Kunalverma1502/Vesc-Shield/README.md

# ⚡️Vesc-Shield 

The Vesc-Shield is a remarkable open-source shield designed for effortless integration with the [Flipsky Vesc 6.7 Pro](https://flipsky.net/products/flipsky-mini-fsesc6-7-pro-70a-base-on-vesc6-6-with-aluminum-anodized-heat-sink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). By doing so, it enables cost-effective utilization in a wide range of robotic applications while affording precise driver control through the seamless integration of Dspace.

# Features 
1. **Enhanced Motor Encoder Output:** Amplifies motor encoder output signals for both Vesc and Dspace, ensuring optimal performance and precision.<br/>
1. **Effortless Position Reset:** Facilitates easy and precise index position resetting, whether through digital or manual methods.<br/>
1. **Motor Driver Control:** Provides the capability to enable or disable the motor driver with simplicity and efficiency.<br/>
1. **Streamlined Connectivity:** Utilizes a single ribbon cable connection to Dspace, consolidating all essential signals for a tidy and efficient setup.<br/>
1. **Informative LEDs:** Equipped with LEDs that display vital information, including power status, enable/disable status, and index reset, ensuring at-a-glance monitoring and feedback.<br/>

# Schematics
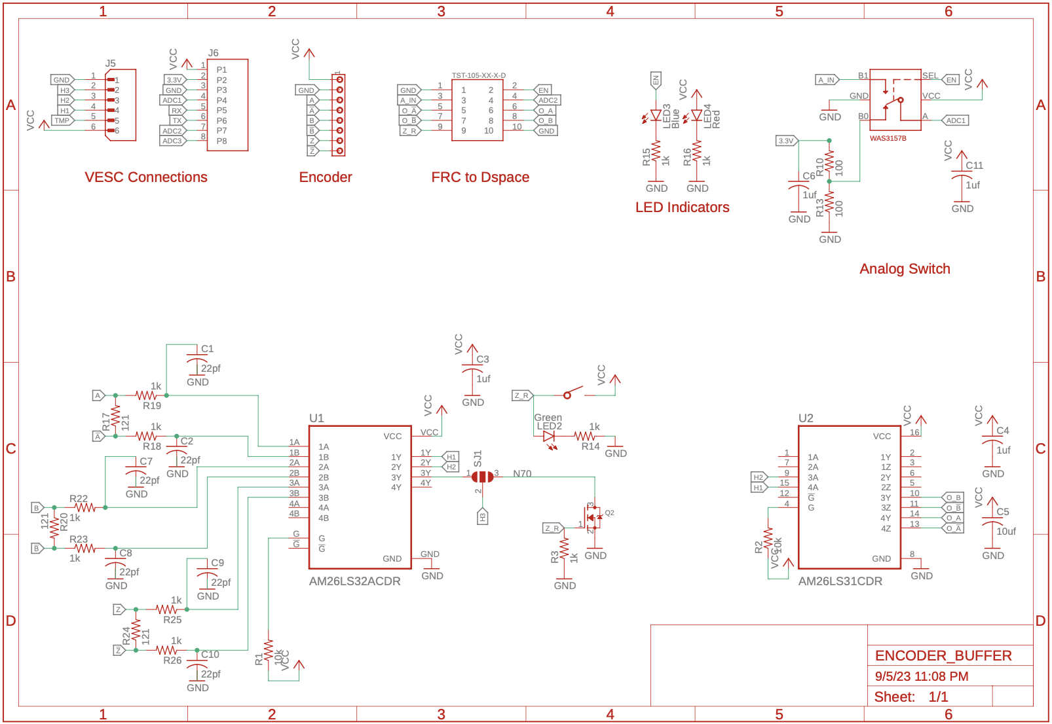
[picture p1: Images/Schematic 2.png]

<br/>
<br/>

# Board 
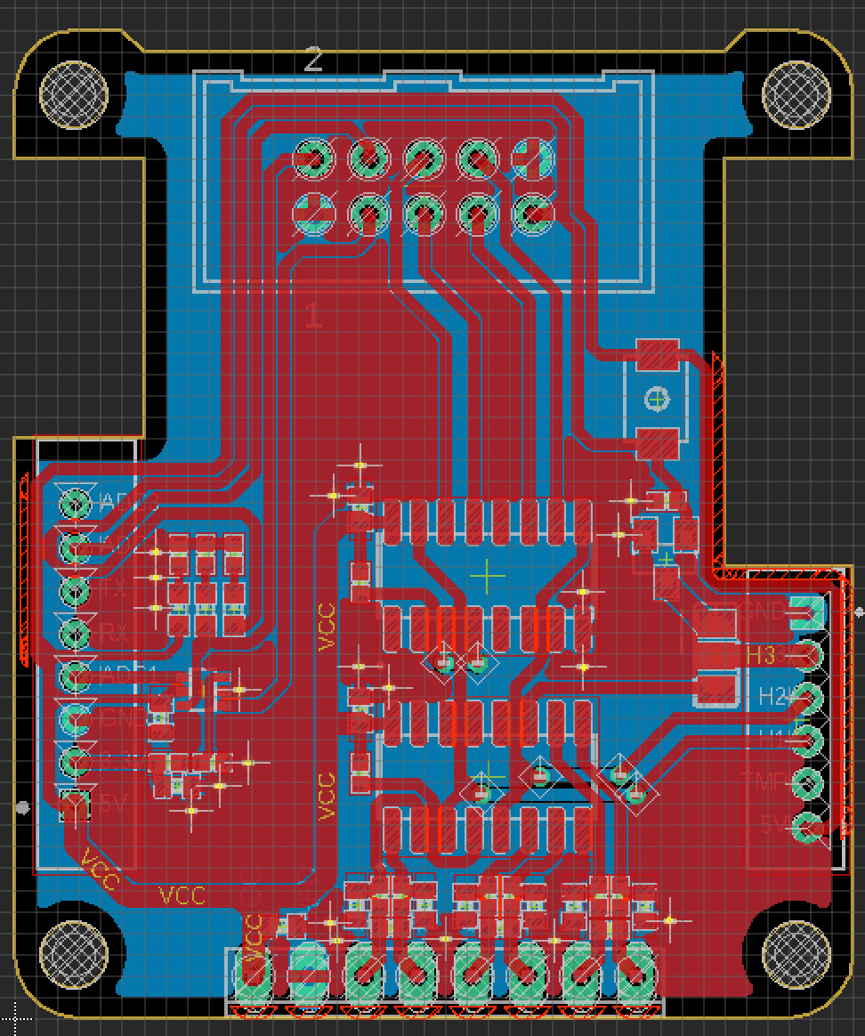
[picture p2: Images/Board.png]

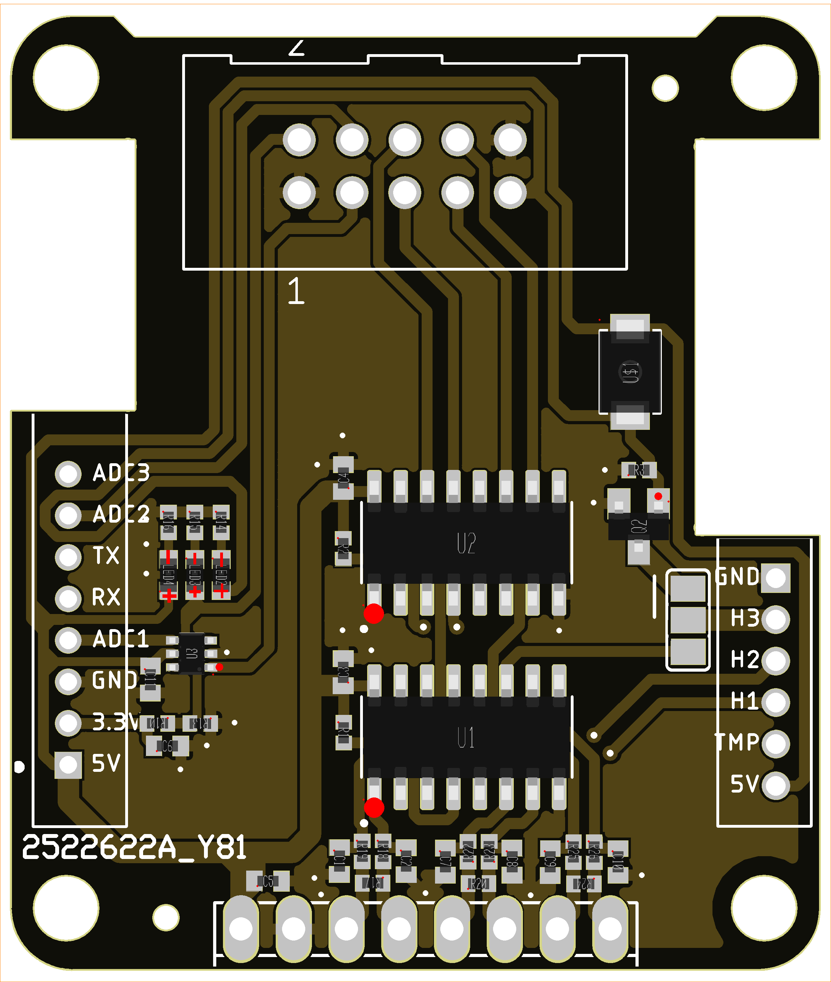
[picture p3: Images/Parts Placement.png]
