Kunalverma1502/Vesc-Shield/Images/Schematics.png

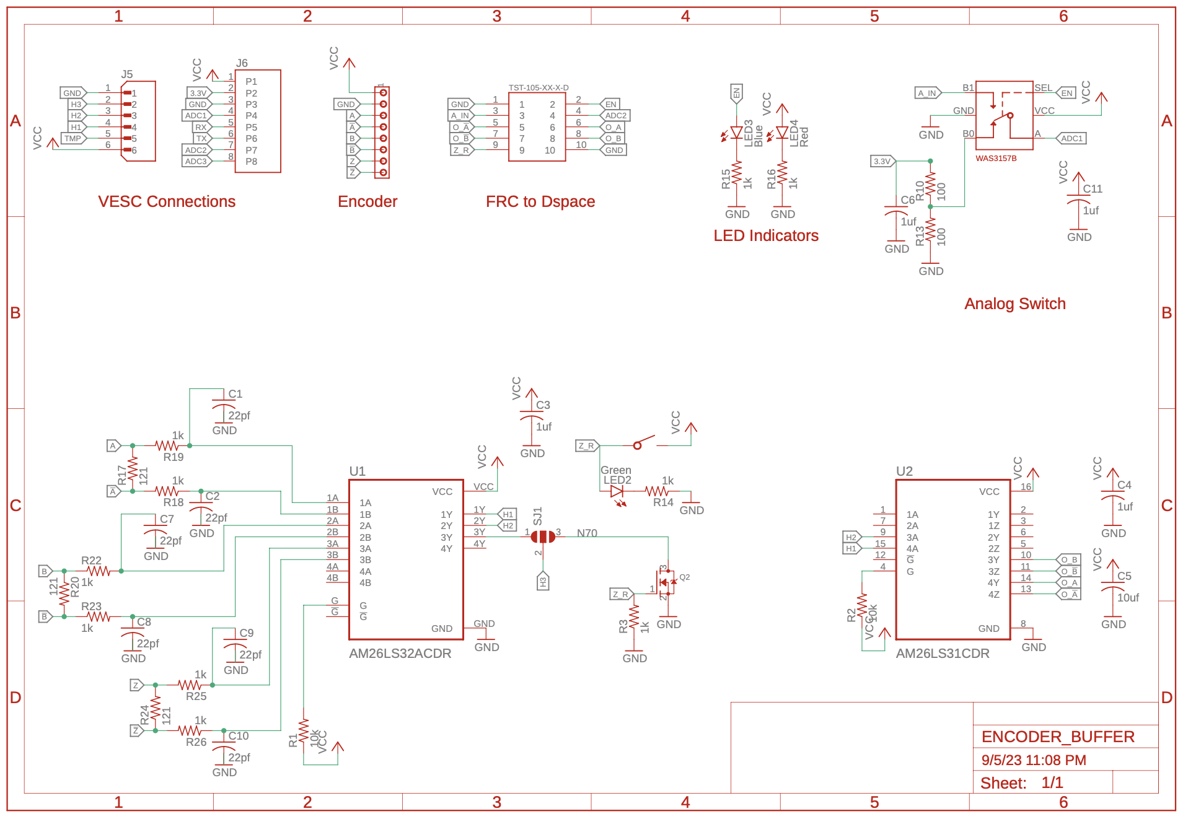
Images/Schematics.png
