Kunalverma1502/Vesc-Shield/PCB Files/ORDER/BOM_ENCODER_BUFFER.xlsx

Comment | Designator | Footprint | JLCPCB Part #（optional）
SI2300 | Q2 | SOT-23 | C2985622
100 | R10, R13 | R0402 | C325391
10k | R1, R2 | R0402 | C375970
10uf | C5 | C0402 | C703695
121 | R17, R20, R24 | R0402 | C25080
1k | R3, R14, R15, R16, R18, R19, R22, R23, R25, R26 | R0402 | C306197
1uf | C3, C4, C6, C11 | C0402 | C415694
22pf | C1, C2, C7, C8, C9, C10 | C0402 | C694268
AM26LS31CDR | U2 | SOIC-16 | C6179
AM26LS32ACDR | U1 | SOIC-16 | C6180
19-213UYOC/S530-A3/TR8 | LED3 | 603 | C264452
19-21/GHC-YR1S2M/3T | LED2 | 603 | C605453
TJ-S1608SW6TDSLC2R2G-A5 | LED4 | 603 | C601671
TS-1088-AR02016 | U$1 | SMD | C720477
WAS3157B-6/TR | U3 | SOT-363 | C213161
