Kunalverma1502/Vesc-Shield/PCB Files/ENCODER_BUFFER.pdf

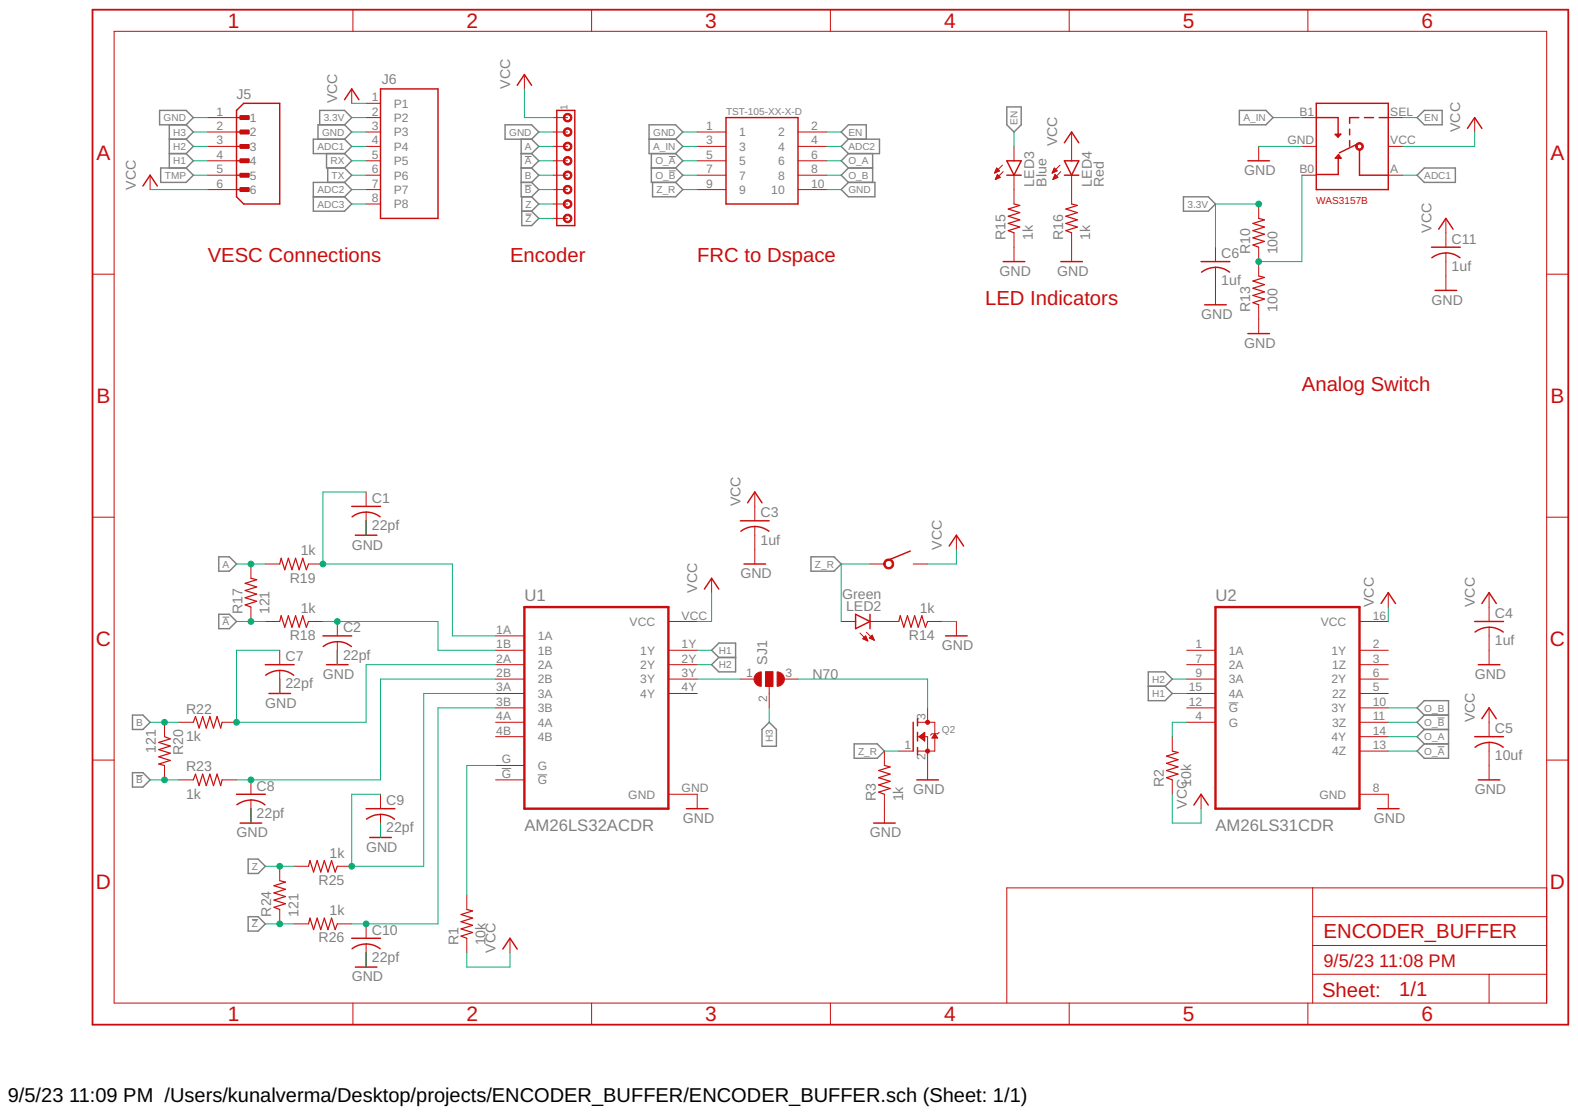
[picture p5: page 1]

9/5/23 11:09 PM /Users/kunalverma/Desktop/projects/ENCODER_BUFFER/ENCODER_BUFFER.sch (Sheet: 1/1)
