Kunalverma1502/Vesc-Shield/PCB Files/ENCODER_BUFFER.brd

## EAGLE design PCB Files/ENCODER_BUFFER.brd (2023-09-06)

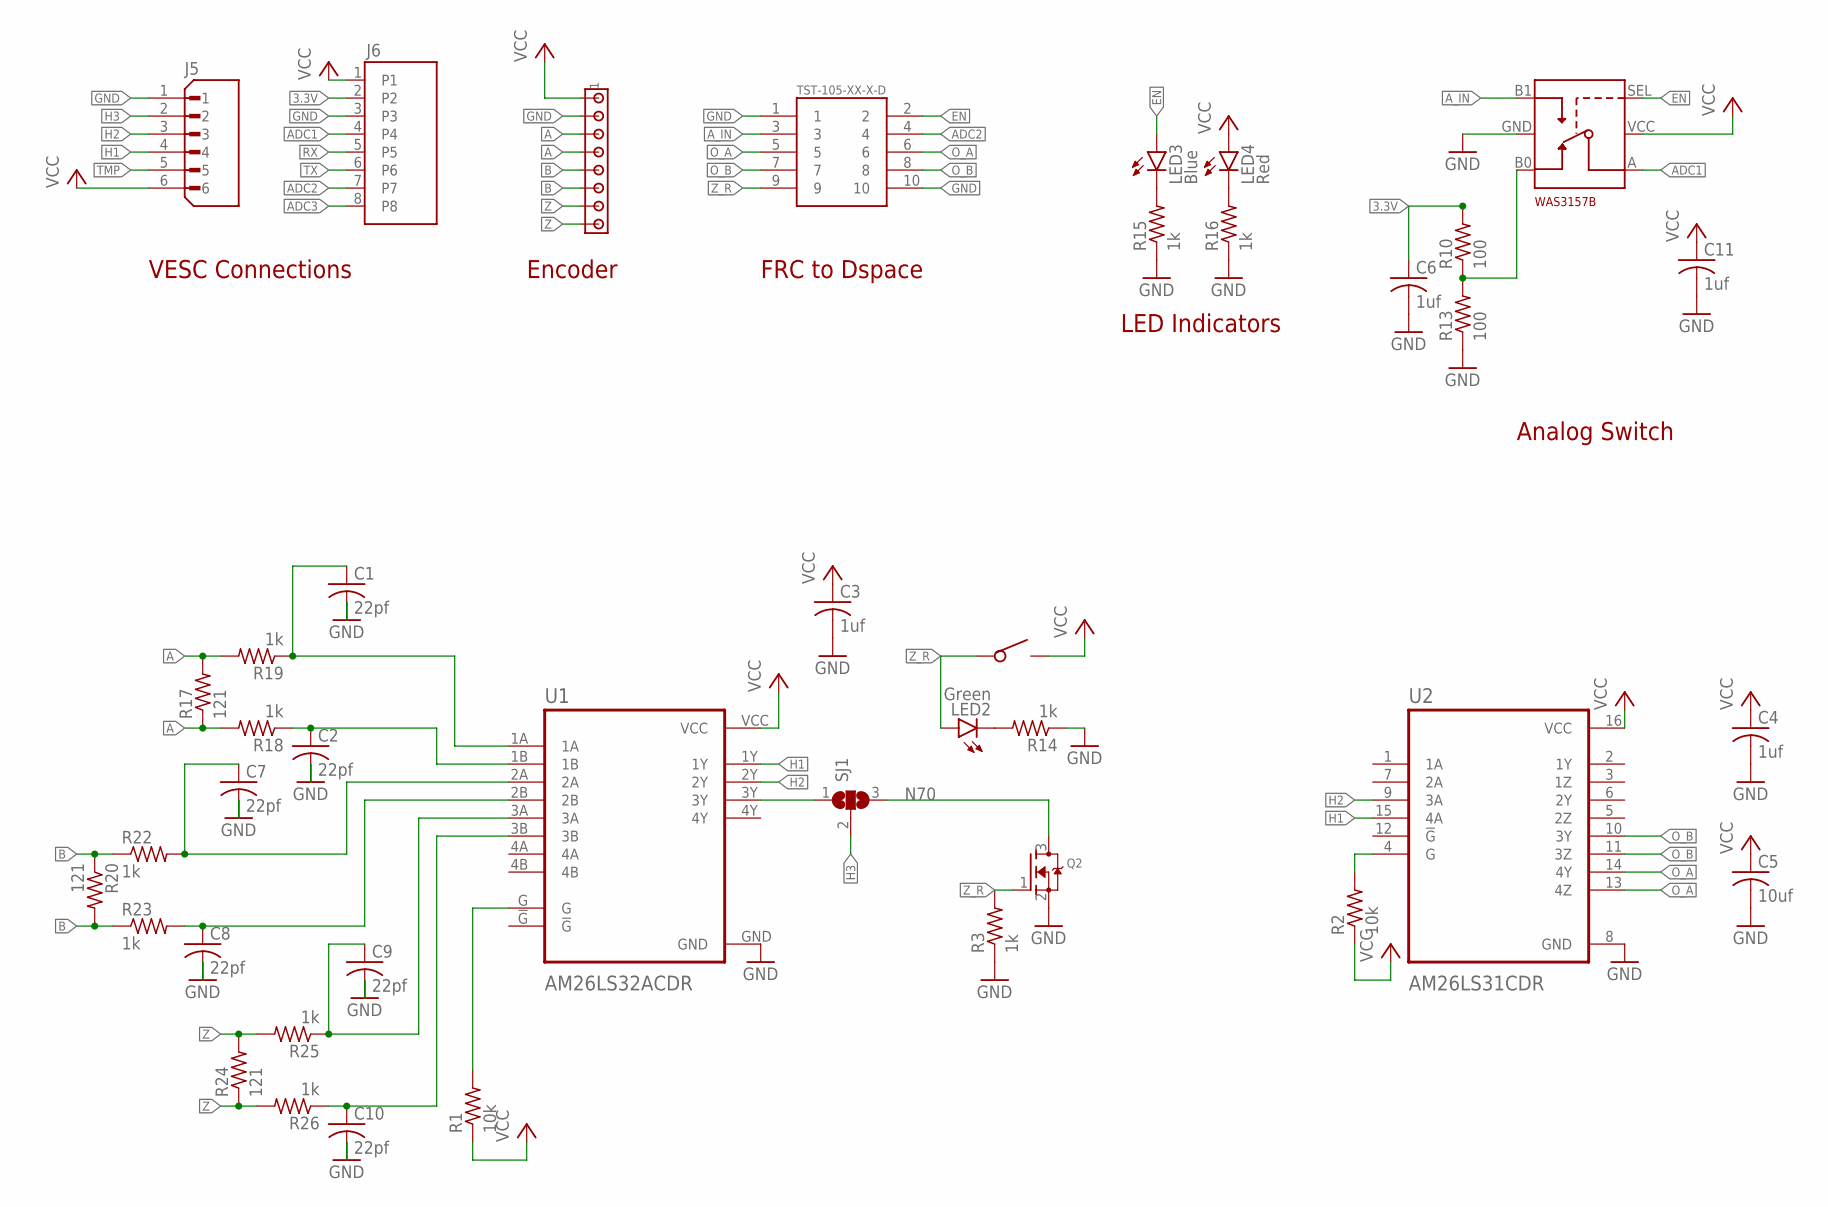
[picture p6: schematic ENCODER_BUFFER.sch]

Parts:
C1, C2, C7, C8, C9, C10: 22pf; C0402
C3, C4, C6, C11: 1uf; C0402
C5: 10uf; C0402
J2: TST-105-XX-X-D
J3: MTA08-100; 10X08MTA
J5: B6B-PH-K-S(LF)(SN); JST_B6B-PH-K-S(LF)(SN)
J6: B8B-PH-K-S(LF)(SN); JST_B8B-PH-K-S(LF)(SN)
LED2: Green; CHIPLED_0603
LED3: Blue; CHIPLED_0603
LED4: Red; CHIPLED_0603
Q2: MOSFET-NREFLOW; SOT23
R1, R2: 10k; R0402
R3, R14, R15, R16, R18, R19, R22, R23, R25, R26: 1k; R0402
R10, R13: 100; R0402
R17, R20, R24: 121; R0402
SJ1: SJ2W; SJ_2
U1: AM26LS32ACDR; SOIC127P600X175-16N
U2: AM26LS31CDR; SOIC127P600X175-16N
U3: WAS3157BUMT6; UMT6
U$1: TS-1088-AR02016; SMD

Connections:
3.3V: C6.1, J6.2, R10.2
3Y: SJ1.1, U1.3Y
!A: J3.4, R17.1, R18.2
!B: J3.6, R20.2, R23.1
!Z: J3.8, R24.1, R26.2
A: J3.3, R17.2, R19.2
ADC1: J6.4, U3.A
ADC2: J2.4, J6.7
ADC3: J6.8
A_IN: J2.3, U3.B1
B: J3.5, R20.1, R22.1
EN: J2.2, LED3.A, U3.SEL
GND: C1.2, C2.2, C3.2, C4.2, C5.2, C6.2, C7.2, C8.2, C9.2, C10.2, C11.2, J2.1, J2.10, J3.2, J5.1, J6.3, Q2.2 (S), R3.1, R13.1, R14.1, R15.1, R16.1, U1.GND, U2.8 (GND), U3.GND
H1: J5.4, U1.1Y, U2.15 (4A)
H2: J5.3, U1.2Y, U2.9 (3A)
H3: J5.2, SJ1.2
N70: Q2.3 (D), SJ1.3
unnamed: C1.1, R19.1, U1.1A
unnamed: C2.1, R18.1, U1.1B
unnamed: R1.2, U1.G
unnamed: R10.1, R13.2, U3.B0
unnamed: C8.1, R23.2, U1.2B
unnamed: C7.1, R22.2, U1.2A
unnamed: LED2.C, R14.2
unnamed: LED3.C, R15.2
unnamed: LED4.C, R16.2
unnamed: R2.2, U2.4 (G)
unnamed: C9.1, R25.1, U1.3A
unnamed: C10.1, R26.1, U1.3B
O_!A: J2.5, U2.13 (4Z)
O_!B: J2.7, U2.11 (3Z)
O_A: J2.6, U2.14 (4Y)
O_B: J2.8, U2.10 (3Y)
RX: J6.5
TMP: J5.5
TX: J6.6
VCC: C3.1, C4.1, C5.1, C11.1, J3.1, J5.6, J6.1, LED4.A, R1.1, R2.1, U1.VCC, U2.16 (VCC), U3.VCC, U$1.P$2
Z: J3.7, R24.2, R25.2
Z_R: J2.9, LED2.A, Q2.1 (G), R3.2, U$1.P$1

Notes on the sheet:
WAS3157B
VESC Connections
Encoder
FRC to Dspace
LED Indicators
Analog Switch

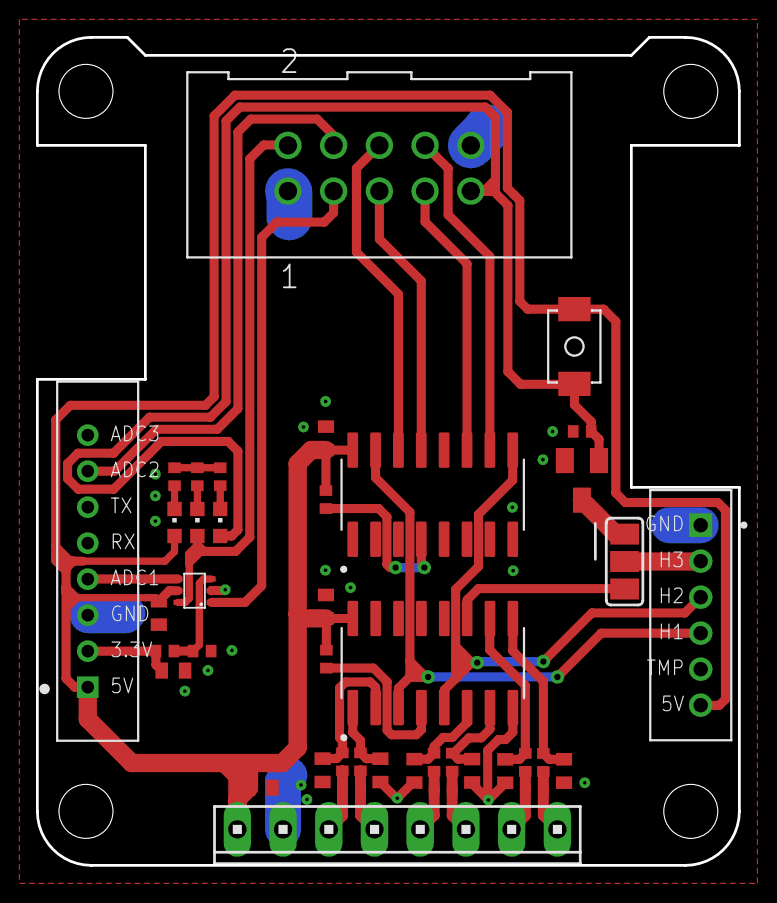
[picture p7: board ENCODER_BUFFER.brd from above]

Board: 2 copper layers, 39.0 x 46.0 mm, 41 parts (0 on the bottom side), 35 nets.
